adriencarbonaro/irrigation-controller/Photos/irrigation_controller.jpg

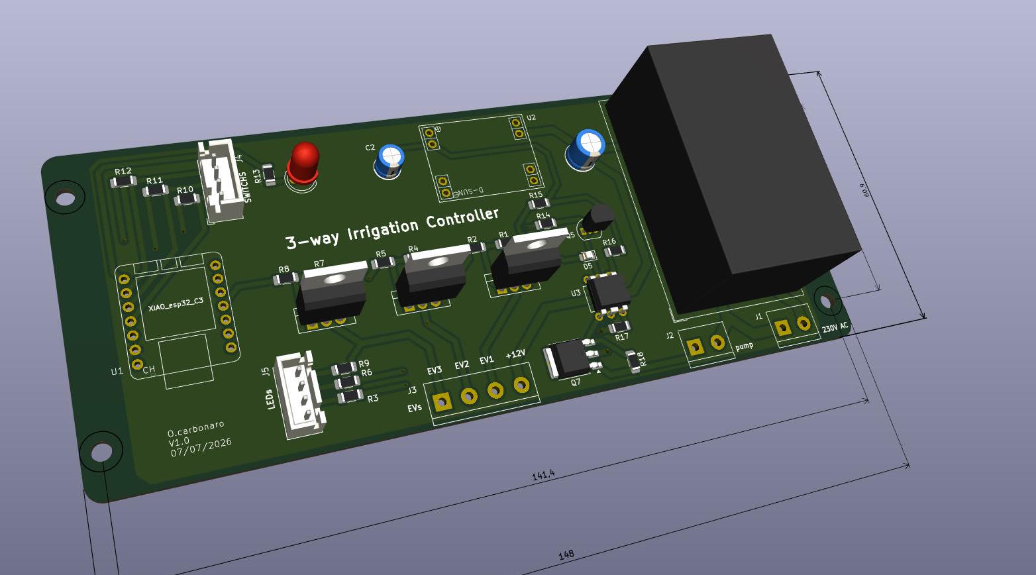
Photos/irrigation_controller.jpg
