adriencarbonaro/irrigation-controller/photos/irrigation_controller_2EVs+pump_complete2.jpg

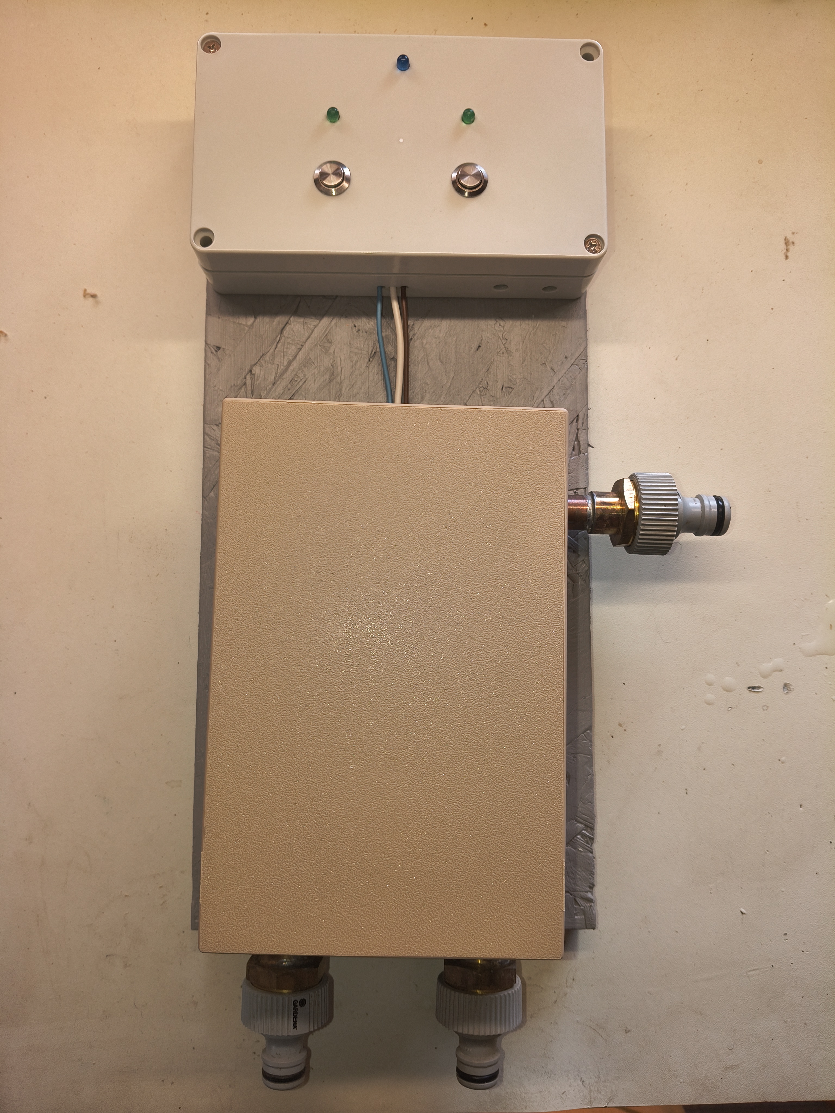
photos/irrigation_controller_2EVs+pump_complete2.jpg
