adriencarbonaro/irrigation-controller/photos/irrigation_controller_naked_pcb_B.jpg

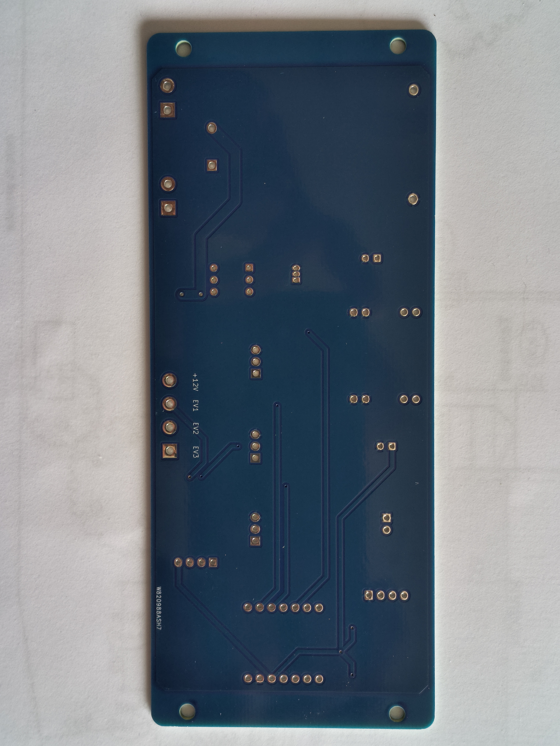
photos/irrigation_controller_naked_pcb_B.jpg
