adriencarbonaro/irrigation-controller/photos/irrigation_controller_naked_pcb_F.jpg

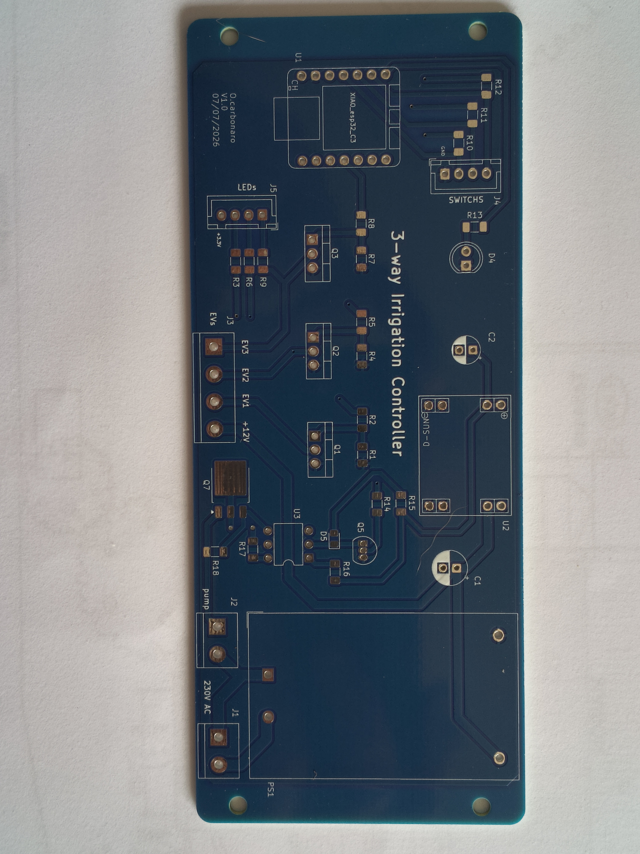
photos/irrigation_controller_naked_pcb_F.jpg
