adriencarbonaro/irrigation-controller/Photos/irrigation_controller_sch.jpg

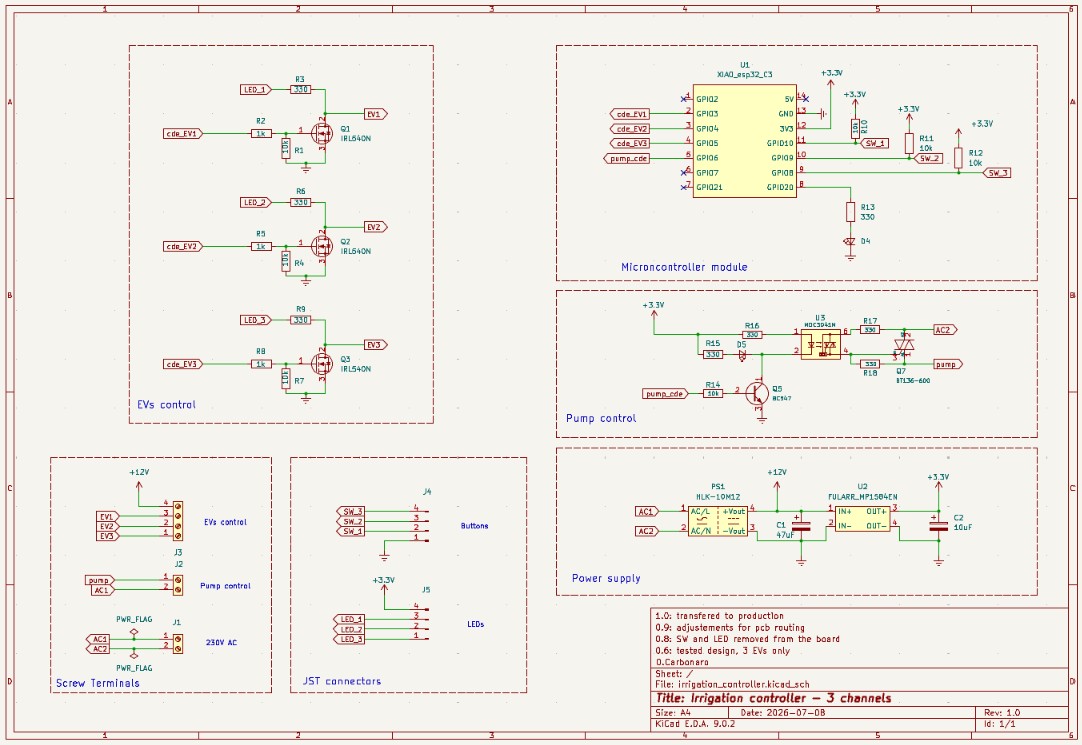
Photos/irrigation_controller_sch.jpg
