adriencarbonaro/irrigation-controller/photos/Prototype_on_ breadbord.jpg

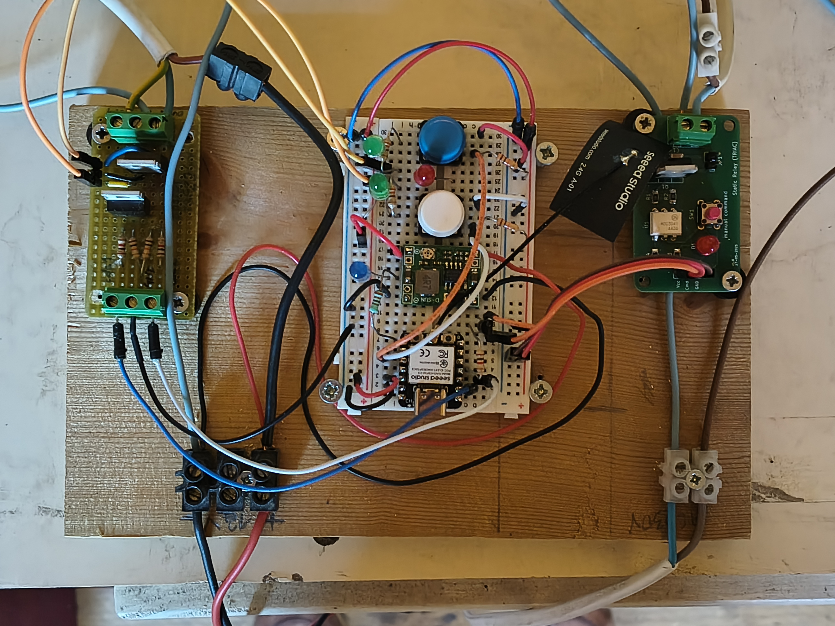
photos/Prototype_on_ breadbord.jpg
