adriencarbonaro/irrigation-controller/hardware/irrigation_controller_2/irrigation_controller.csv

Reference | Qty | Value | DNP | Exclude from BOM | Exclude from Board | Footprint | Datasheet
C1 | 1 | 47uF |  |  |  | Capacitor_THT:CP_Radial_D6.3mm_P2.50mm | ~
C2 | 1 | 10uF |  |  |  | Capacitor_THT:CP_Radial_D5.0mm_P2.50mm | ~
D4 | 1 | LED_Small |  |  |  | LED_THT:LED_D5.0mm | ~
D5 | 1 | LED_Small |  |  |  | LED_SMD:LED_0805_2012Metric_Pad1.15x1.40mm_HandSolder | ~
J1,J2 | 2 | Screw_Terminal_01x02 |  |  |  | TerminalBlock:TerminalBlock_bornier-2_P5.08mm | ~
J3 | 1 | Screw_Terminal_01x04 |  |  |  | TerminalBlock:TerminalBlock_bornier-4_P5.08mm | ~
J4,J5 | 2 | Conn_01x04_Pin |  |  |  | Connector_JST:JST_XH_B4B-XH-A_1x04_P2.50mm_Vertical | ~
PS1 | 1 | HLK-10M12 |  |  |  | Converter_ACDC:Converter_ACDC_Hi-Link_HLK-10Mxx | http://h.hlktech.com/download/ACDC%E7%94%B5%E6%BA%90%E6%A8%A1%E5%9D%9710W%E7%B3%BB%E5%88%97/1/%E6%B5%B7%E5%87%8C%E7%A7%9110W%E7%B3%BB%E5%88%97%E7%94%B5%E6%BA%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
Q1,Q2,Q3 | 3 | IRL540N |  |  |  | Package_TO_SOT_THT:TO-220-3_Vertical | http://www.irf.com/product-info/datasheets/data/irf540n.pdf
Q5 | 1 | BC547 |  |  |  | Package_TO_SOT_THT:TO-92_Inline | https://www.onsemi.com/pub/Collateral/BC550-D.pdf
Q7 | 1 | BT136-600 |  |  |  | Package_TO_SOT_SMD:TO-252-3_TabPin2 | http://www.micropik.com/PDF/BT136-600.pdf
R1,R4,R7,R10,R11,R12,R14 | 7 | 10k |  |  |  | Resistor_SMD:R_1206_3216Metric_Pad1.30x1.75mm_HandSolder | ~
R2,R5,R8 | 3 | 1k |  |  |  | Resistor_SMD:R_1206_3216Metric_Pad1.30x1.75mm_HandSolder | ~
R3,R6,R9,R13,R15,R16,R17,R18 | 8 | 330 |  |  |  | Resistor_SMD:R_1206_3216Metric_Pad1.30x1.75mm_HandSolder | ~
U1 | 1 | XIAO_esp32_C3 |  |  |  | Carbonaro:XIAO_ESP32_C3
U2 | 1 | FULARR_MP1584EN |  |  |  | Carbonaro:FULARR_MP1584EN
U3 | 1 | MOC3041M |  |  |  | Package_DIP:DIP-6_W7.62mm | https://www.onsemi.com/pub/Collateral/MOC3043M-D.pdf
