adriencarbonaro/irrigation-controller/hardware/irrigation_controller_2/irrigation_controller.kicad_pcb

## KiCad design hardware/irrigation_controller_2/irrigation_controller.kicad_pcb (2026-08-14)

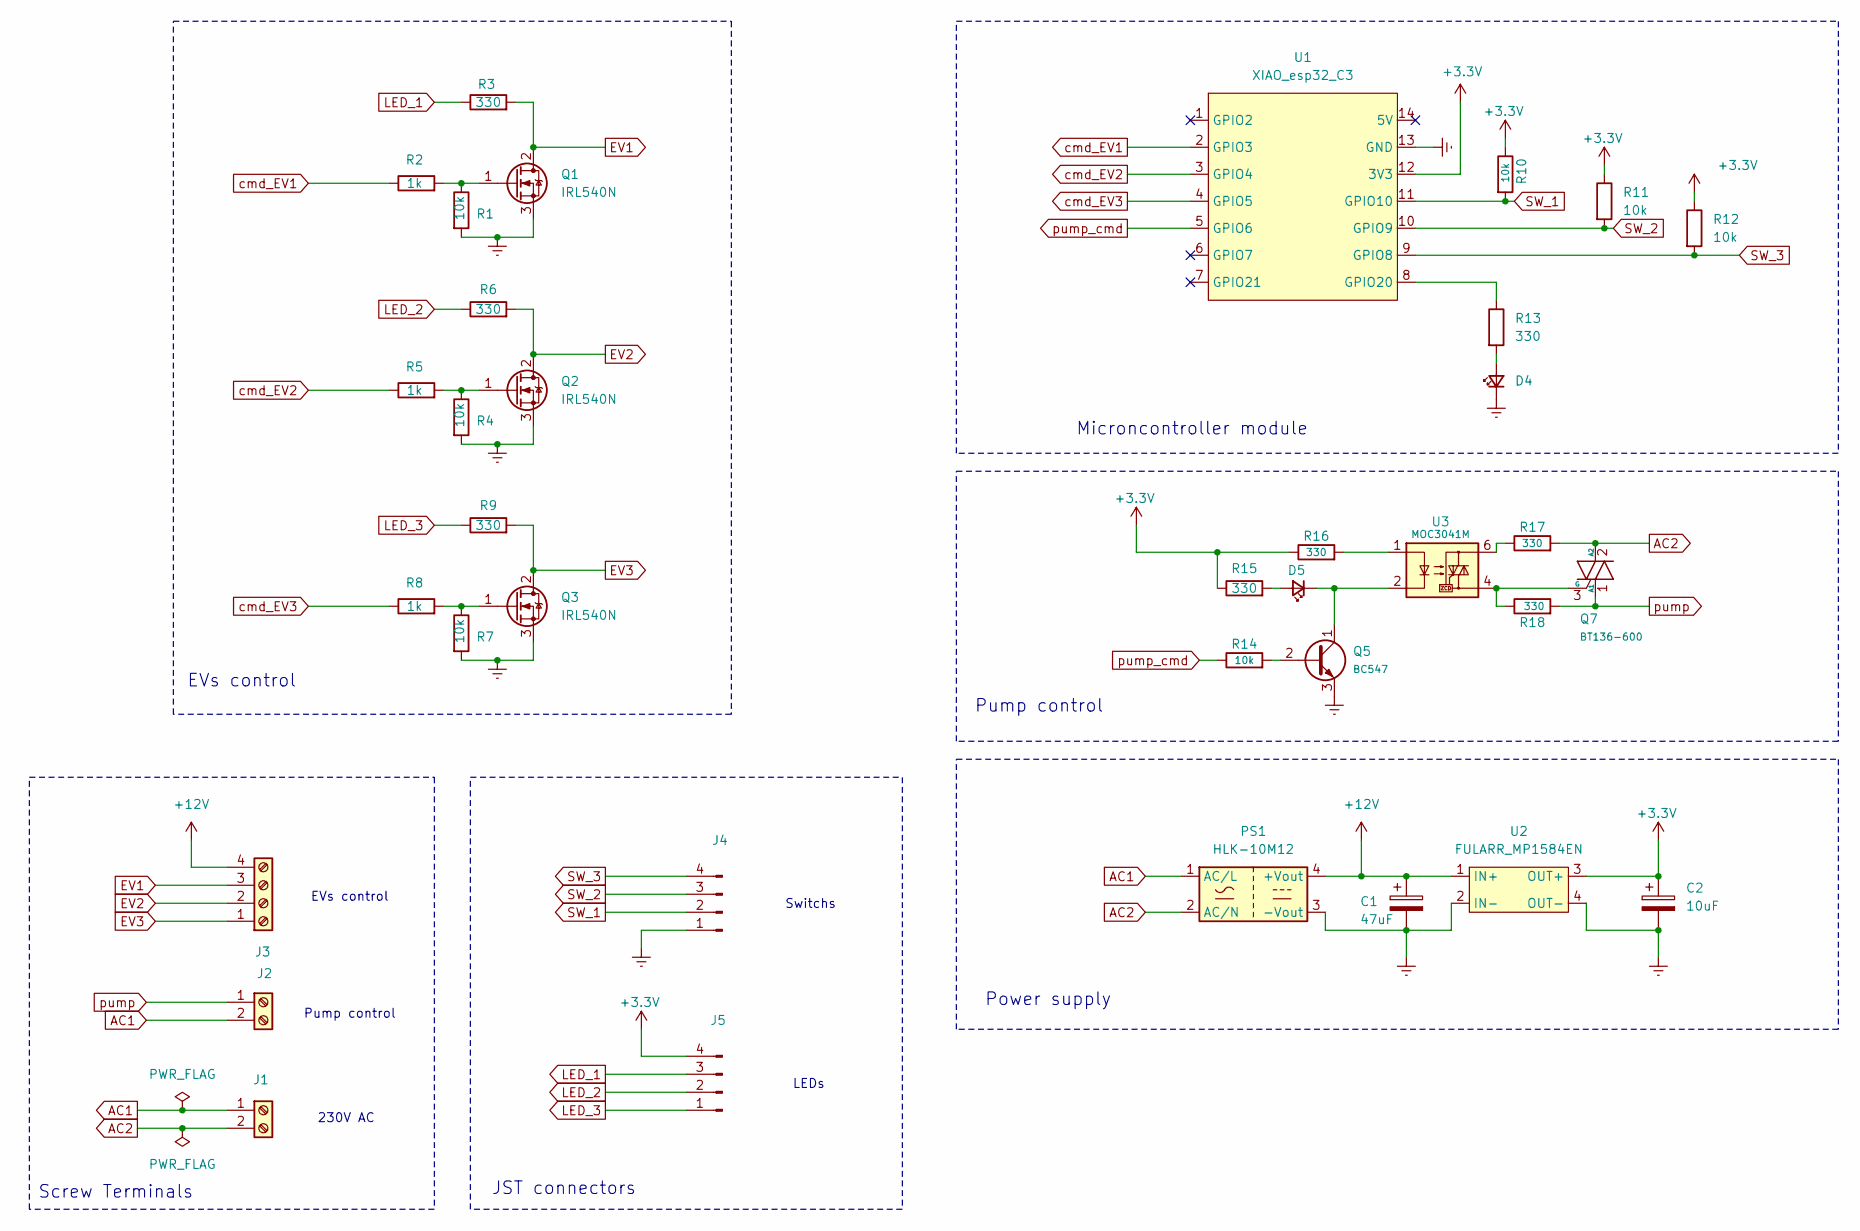
[picture p16: schematic irrigation_controller.kicad_sch, Irrigation controller - 3 channels]

Parts:
C1: 47uF; CP_Radial_D6.3mm_P2.50mm
C2: 10uF; CP_Radial_D5.0mm_P2.50mm
D4: LED_Small; LED_D5.0mm
D5: LED_Small; LED_0805_2012Metric_Pad1.15x1.40mm_HandSolder
J1, J2: Screw_Terminal_01x02; TerminalBlock_bornier-2_P5.08mm
J3: Screw_Terminal_01x04; TerminalBlock_bornier-4_P5.08mm
J4, J5: Conn_01x04_Pin; JST_XH_B4B-XH-A_1x04_P2.50mm_Vertical
PS1: HLK-10M12; Converter_ACDC_Hi-Link_HLK-10Mxx
Q1, Q2, Q3: IRL540N; TO-220-3_Vertical
Q5: BC547; TO-92_Inline
Q7: BT136-600; TO-252-3_TabPin2
R1, R4, R7, R10, R11, R12, R14: 10k; R_1206_3216Metric_Pad1.30x1.75mm_HandSolder
R2, R5, R8: 1k; R_1206_3216Metric_Pad1.30x1.75mm_HandSolder
R3, R6, R9, R13, R15, R16, R17, R18: 330; R_1206_3216Metric_Pad1.30x1.75mm_HandSolder
U1: XIAO_esp32_C3; XIAO_ESP32_C3
U2: FULARR_MP1584EN
U3: MOC3041M; DIP-6_W7.62mm

Connections:
+3.3V: C2.1, J5.4, R10.1, R11.1, R12.1, R15.1, R16.1, U1.12 (3V3), U2.3 (OUT+)
+12V: C1.1, J3.4, PS1.4 (+Vout), U2.1 (IN+)
AC1: J1.1, J2.2, PS1.1 (AC/L)
AC2: J1.2, PS1.2 (AC/N), Q7.2 (A2), R17.2
EV1: J3.3, Q1.2 (D), R3.2
EV2: J3.2, Q2.2 (D), R6.2
EV3: J3.1, Q3.2 (D), R9.2
GND: C1.2, C2.2, D4.1 (K), J4.1, PS1.3 (-Vout), Q1.3 (S), Q2.3 (S), Q3.3 (S), Q5.3 (E), R1.2, R4.2, R7.2, U1.13 (GND), U2.2 (IN-), U2.4 (OUT-)
LED_1: J5.3, R3.1
LED_2: J5.2, R6.1
LED_3: J5.1, R9.1
unnamed: D4.2 (A), R13.2
unnamed: D5.2 (A), R15.2
unnamed: D5.1 (K), Q5.1 (C), U3.2
unnamed: Q1.1 (G), R1.1, R2.2
unnamed: Q2.1 (G), R4.1, R5.2
unnamed: Q3.1 (G), R7.1, R8.2
unnamed: Q5.2 (B), R14.2
unnamed: Q7.3 (G), R18.1, U3.4
unnamed: R16.2, U3.1
unnamed: R17.1, U3.6
unnamed: R13.1, U1.8 (GPIO20)
SW_1: J4.2, R10.2, U1.11 (GPIO10)
SW_2: J4.3, R11.2, U1.10 (GPIO9)
SW_3: J4.4, R12.2, U1.9 (GPIO8)
cmd_EV1: R2.1, U1.2 (GPIO3)
cmd_EV2: R5.1, U1.3 (GPIO4)
cmd_EV3: R8.1, U1.4 (GPIO5)
pump: J2.1, Q7.1 (A1), R18.2
pump_cmd: R14.1, U1.5 (GPIO6)

Notes on the sheet:
LEDs
JST connectors
Microncontroller module
EVs control
Pump control
Power supply
Screw Terminals
Switchs
230V AC

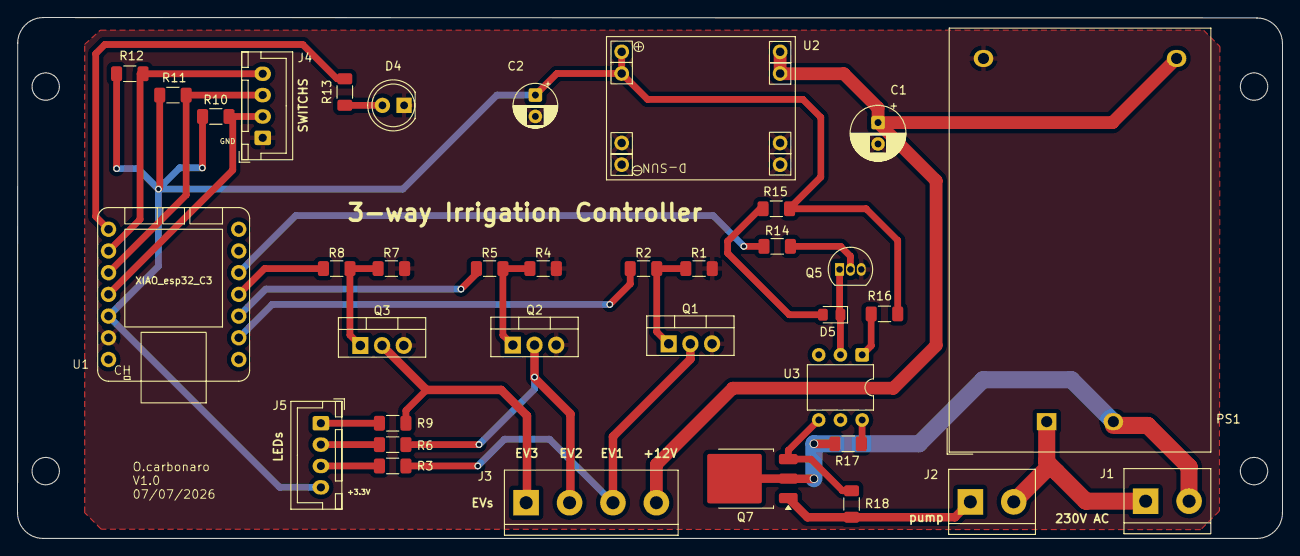
[picture p17: board irrigation_controller.kicad_pcb from above]

Board: 2 copper layers, 148.0 x 61.0 mm, 36 parts (0 on the bottom side), 30 nets.
