adriencarbonaro/irrigation-controller/(commit log)

2026-07-08 adding kicad pcb
2026-08-14 prototype firmware commit
2026-08-22 actual status of the valves are exposed to HA
