adriencarbonaro/irrigation-controller/photos/irrigation_controller_2EVs+pump_board+buttons.jpg

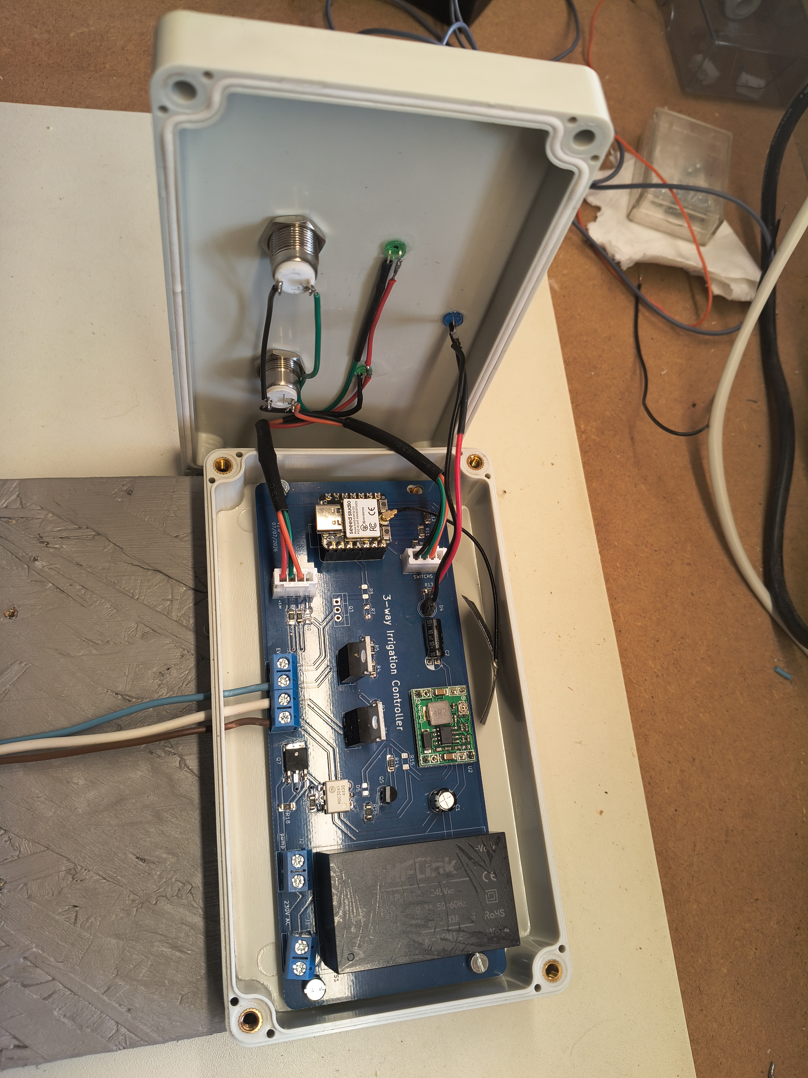
photos/irrigation_controller_2EVs+pump_board+buttons.jpg
