adriencarbonaro/irrigation-controller/photos/irrigation_controller_2EVs+pump_complete3.jpg

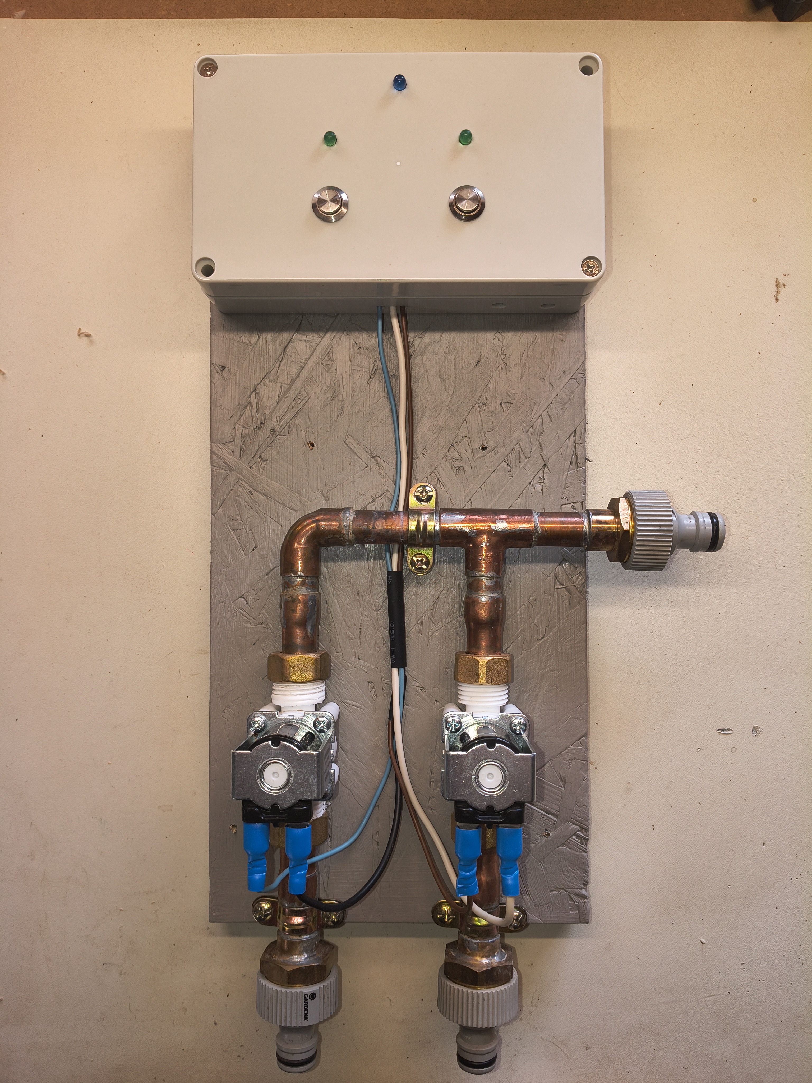
photos/irrigation_controller_2EVs+pump_complete3.jpg
