adriencarbonaro/irrigation-controller/photos/irrigation_controller_2EVs+pump_complete4.jpg

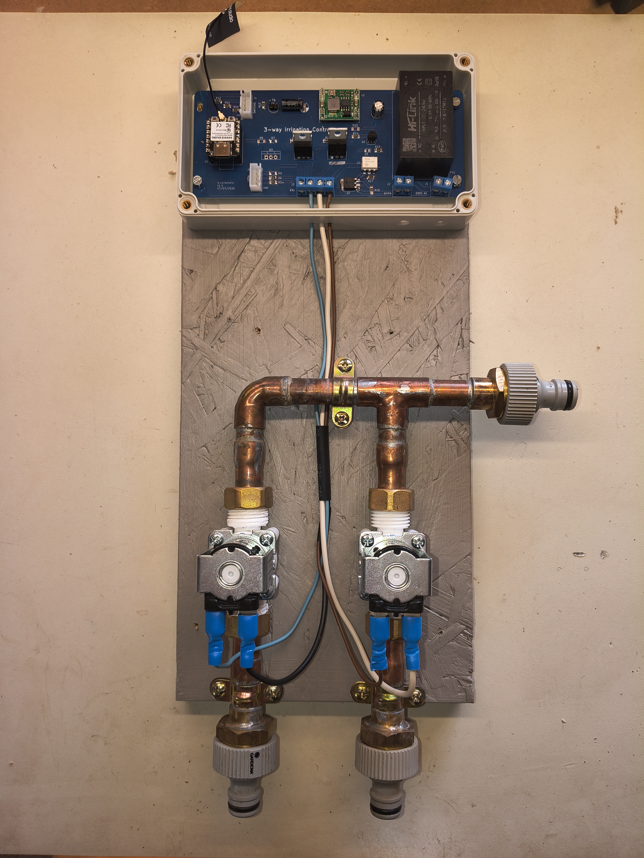
photos/irrigation_controller_2EVs+pump_complete4.jpg
