adriencarbonaro/irrigation-controller/photos/irrigation_controller_2EVs+pump_complete.jpg

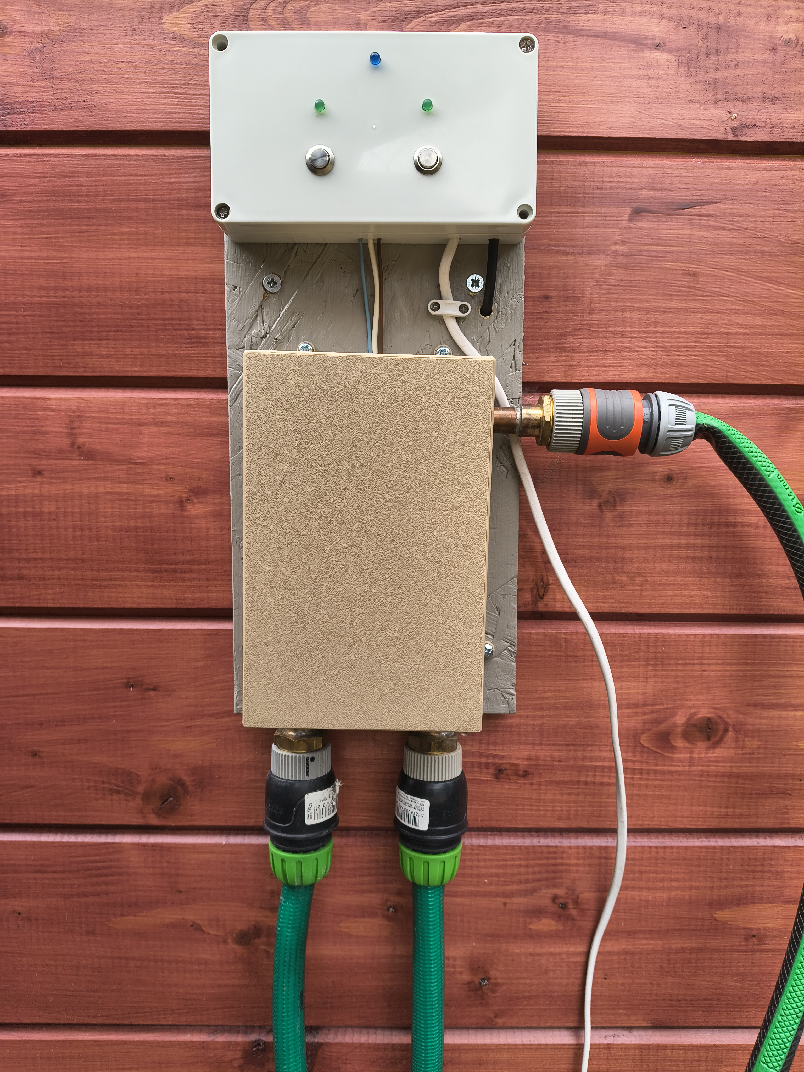
photos/irrigation_controller_2EVs+pump_complete.jpg
