adriencarbonaro/irrigation-controller/Photos/Prototype_partie_hydraulique.jpg

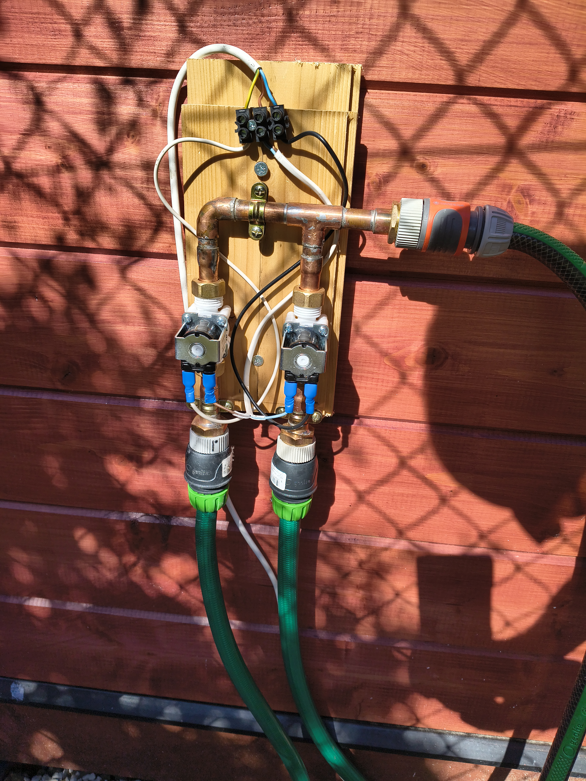
Photos/Prototype_partie_hydraulique.jpg
